tgtakaoka/CyborgHD6309E/schematic/cyborg-hd6309e-prototype5.pdf

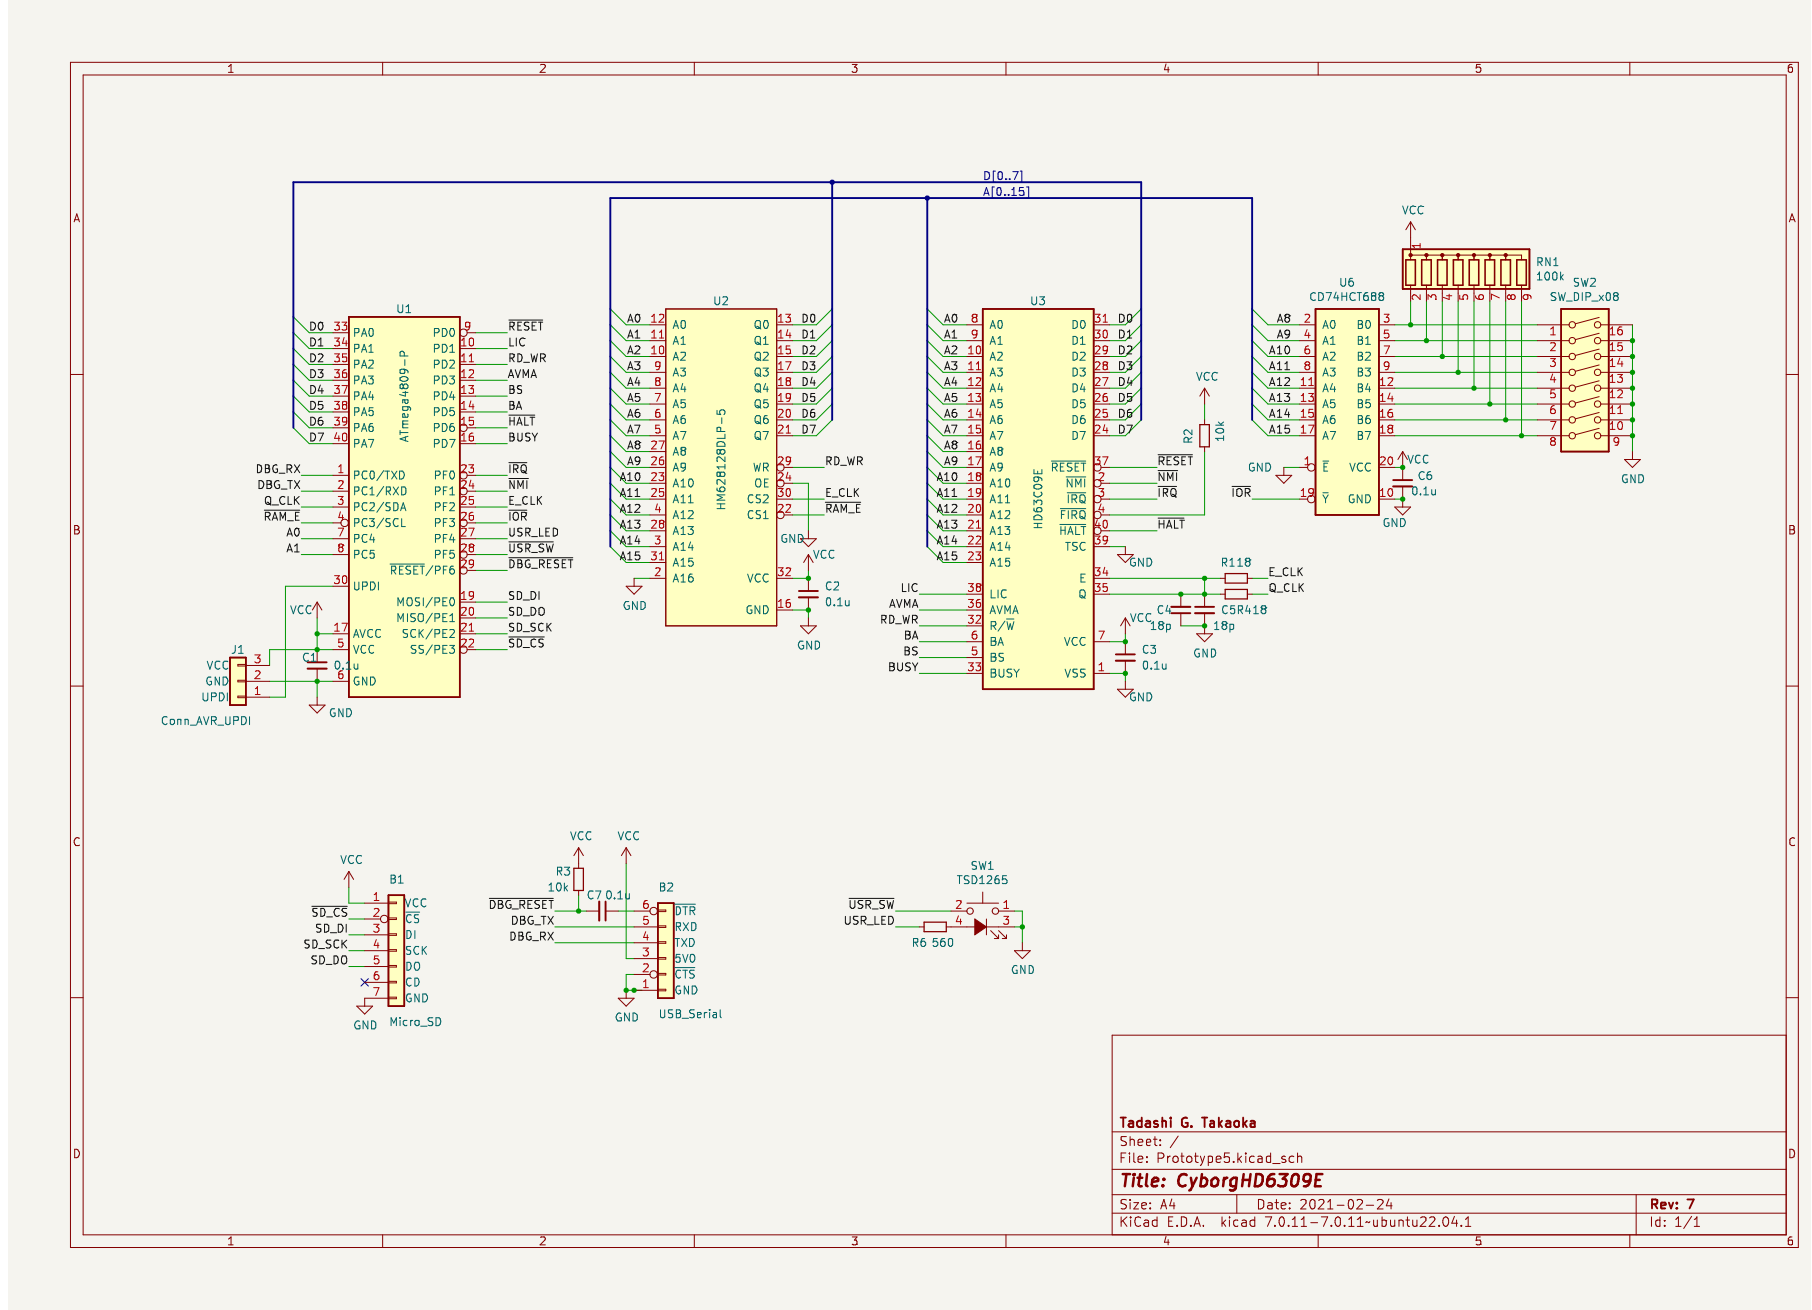
[picture p1: page 1]
