tgtakaoka/CyborgHD6309E/Prototype3/schematic/Prototype3.kicad_pcb

## KiCad design Prototype3/schematic/Prototype3.kicad_pcb (2022-10-26, an earlier design)

Schematic: Prototype3.kicad_sch, Cyborg09 Prototype3

Parts:
C1, C2, C5, C6, C7: 0.1u; C_0603_1608Metric
C3, C4, C8, C9: 22p; C_0402_1005Metric
D1: USR_LED; LED_D3.0mm
J1: Conn_USB_Serial; PinSocket_1x06_P2.54mm_Vertical
J2, J4: Conn_AVR_ISP; PinSocket_1x06_P2.54mm_Vertical
J3: Conn_Micro_SD; PinSocket_1x07_P2.54mm_Vertical
R1, R3, R4: 10k; R_0603_1608Metric
R2: 560; R_0603_1608Metric
SW1: USR_SW; Push_E-Switch_KS01Q01
U1: ATmega1284P-PU; DIP-40_W15.24mm_Socket
U2: HM628128DLP-5; DIP-32_W15.24mm_Socket
U3: HD63C09E; DIP-40_W15.24mm_Socket
U4: ATmega328P-PU; DIP-28_W7.62mm_Socket
Y1, Y2: 20MHz; Crystal_SMD_SeikoEpson_FA238-4Pin_3.2x2.5mm

Connections:
/A0: U1.3 (PB2), U2.12 (A0), U3.8 (A0)
/A1: U1.4 (PB3), U2.11 (A1), U3.9 (A1)
/A2: J4.4 (MISO), U2.10 (A2), U3.10 (A2), U4.18 (PB4)
/A3: J4.5 (MOSI), U2.9 (A3), U3.11 (A3), U4.17 (PB3)
/A4: U2.8 (A4), U3.12 (A4), U4.16 (PB2)
/A5: U2.7 (A5), U3.13 (A5), U4.2 (PD0)
/A6: U2.6 (A6), U3.14 (A6), U4.15 (PB1)
/A7: J4.3 (SCK), U2.5 (A7), U3.15 (A7), U4.19 (PB5)
/A8: U2.27 (A8), U3.16 (A8), U4.14 (PB0)
/A9: U2.26 (A9), U3.17 (A9), U4.3 (PD1)
/A10: U2.23 (A10), U3.18 (A10), U4.4 (PD2)
/A11: U2.25 (A11), U3.19 (A11), U4.5 (PD3)
/A12: U2.4 (A12), U3.20 (A12), U4.6 (PD4)
/A13: U2.28 (A13), U3.21 (A13), U4.11 (PD5)
/A14: U2.3 (A14), U3.22 (A14), U4.12 (PD6)
/A15: U2.31 (A15), U3.23 (A15), U4.13 (PD7)
/AVMA: U1.26 (PC4), U3.36 (AVMA)
/BA: U1.27 (PC5), U3.6 (BA)
/BS: U1.29 (PC7), U3.5 (BS)
/BUSY: U1.25 (PC3), U3.33 (BUSY)
/D0: U1.40 (PA0), U2.13 (Q0), U3.31 (D0)
/D1: U1.39 (PA1), U2.14 (Q1), U3.30 (D1)
/D2: U1.38 (PA2), U2.15 (Q2), U3.29 (D2)
/D3: U1.37 (PA3), U2.17 (Q3), U3.28 (D3)
/D4: U1.36 (PA4), U2.18 (Q4), U3.27 (D4)
/D5: U1.35 (PA5), U2.19 (Q5), U3.26 (D5)
/D6: U1.34 (PA6), U2.20 (Q6), U3.25 (D6)
/D7: U1.33 (PA7), U2.21 (Q7), U3.24 (D7)
/DBG_RX: J1.3 (TXD), U1.14 (RXD0/PD0)
/DBG_TX: J1.2 (RXD), U1.15 (TXD0/PD1)
/E_CLK: U2.30 (CS2), U3.34 (E), U4.27 (PC4)
/LIC: U1.28 (PC6), U3.38 (LIC)
/Q_CLK: U3.35 (Q), U4.28 (PC5)
/RD_WR: U1.24 (PC2), U2.29 (WR), U3.32 (R/~W)
/SD_DI: J2.5 (MOSI), J3.3 (DI), U1.6 (PB5/MOSI)
/SD_DO: J2.4 (MISO), J3.5 (DO), U1.7 (PB6/MISO)
/SD_SCK: J2.3 (SCK), J3.4 (SCK), U1.8 (PB7/SCK)
/USR_LED: D1.2 (A), U1.18 (PD4)
/~ACK: U1.20 (PD6), U4.25 (PC2)
/~DBG_RST: C2.2, J2.1 (~RESET), R1.1, U1.9 (~RESET)
/~HALT: U1.23 (PC1), U3.40 (~HALT)
/~INT: U1.17 (PD3), U4.26 (PC3)
/~IRQ: U1.2 (PB1), U3.3 (~IRQ)
/~NMI: U1.1 (PB0), U3.2 (~NMI)
/~RAM_E: U1.19 (PD5), U2.22 (CS1)
/~RESET: U1.22 (PC0), U3.37 (~RESET)
/~SD_CS: J3.2 (~CS), U1.5 (PB4/~SS)
/~STEP: U1.21 (PD7), U4.24 (PC1)
/~USR_SW: SW1.1, U1.16 (PD2)
GND: C1.2, C3.2, C4.1, C5.2, C6.2, C7.2, C8.2, C9.1, J1.5 (~CTS), J1.6 (GND), J2.6 (GND), J3.7 (GND), J4.6 (GND), R2.1, SW1.2, U1.11 (GND), U1.31 (GND), U2.2 (A16), U2.16 (GND), U2.24 (OE), U3.1 (VSS), U3.39 (TSC), U4.8 (GND), U4.22 (GND)
unnamed: C2.1, J1.1 (~DTR)
unnamed: C3.1, U1.13 (XTAL1), Y1.1
unnamed: C4.2, U1.12 (XTAL2), Y1.2
unnamed: C8.1, U4.9 (XTAL1), Y2.1
unnamed: C9.2, U4.10 (XTAL2), Y2.2
unnamed: D1.1 (K), R2.2
unnamed: J4.1 (~RESET), R4.1, U4.1 (~RESET)
unnamed: R3.1, U3.4 (~FIRQ)
VCC: C1.1, C5.1, C6.1, C7.1, J1.4 (5V0), J2.2 (VCC), J3.1 (VCC), J4.2 (VCC), R1.2, R3.2, R4.2, U1.10 (VCC), U1.30 (AVCC), U2.32 (VCC), U3.7 (VCC), U4.7 (VCC), U4.20 (AVCC)

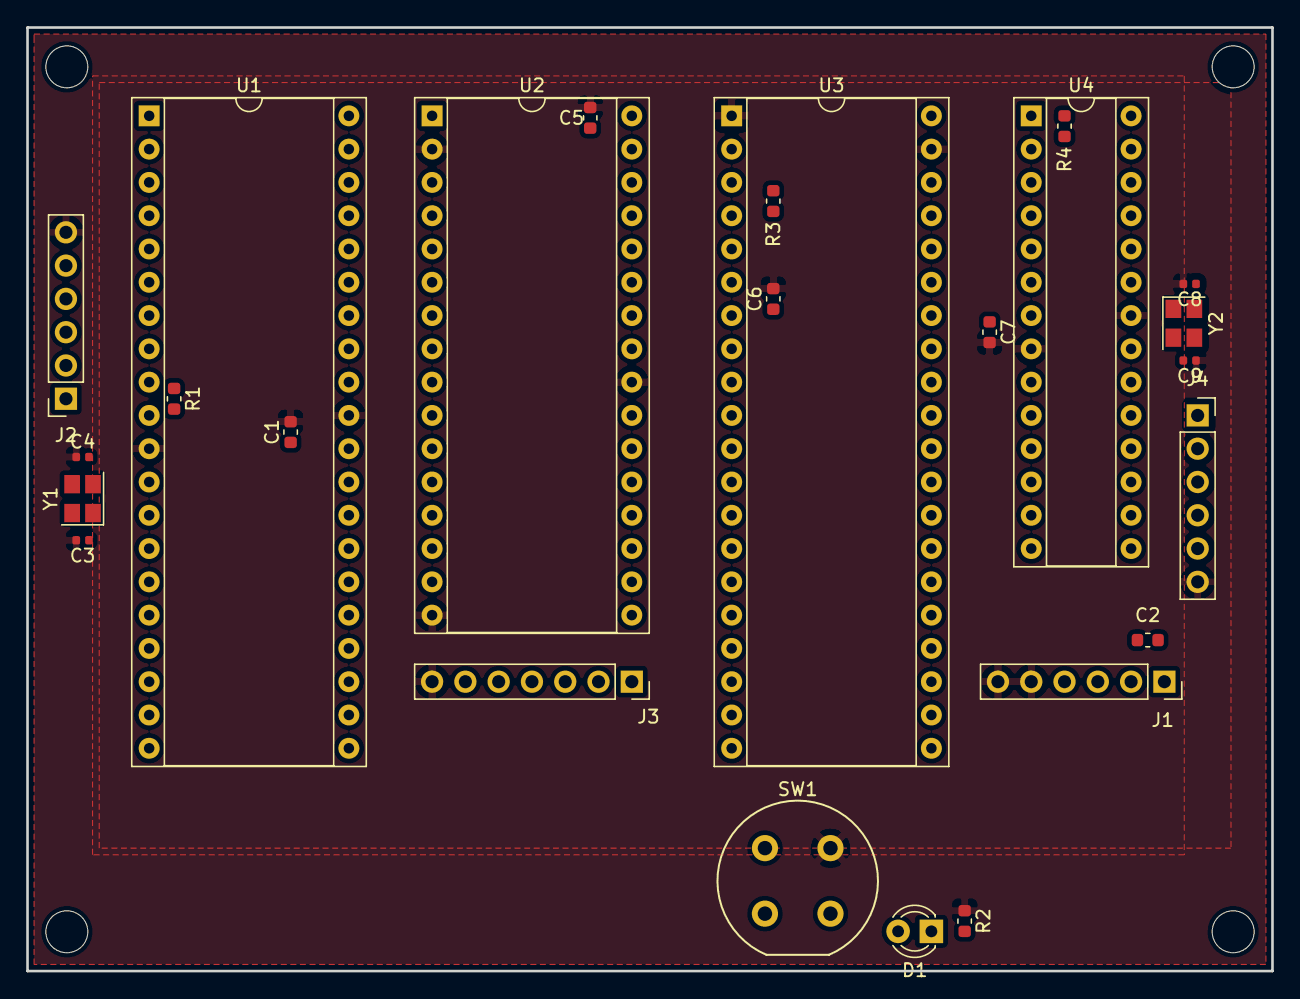
[picture p2: board Prototype3.kicad_pcb from above]

Board: 2 copper layers, 95.0 x 72.0 mm, 29 parts (0 on the bottom side), 59 nets, no tracks yet.

Other parts of the board:
MH1, MH2, MH3, MH4: MountingHole_3.2mm_M3
