tgtakaoka/CyborgHD6309E/schematic/Prototype5.kicad_pcb

## KiCad design schematic/Prototype5.kicad_pcb (2022-10-26)

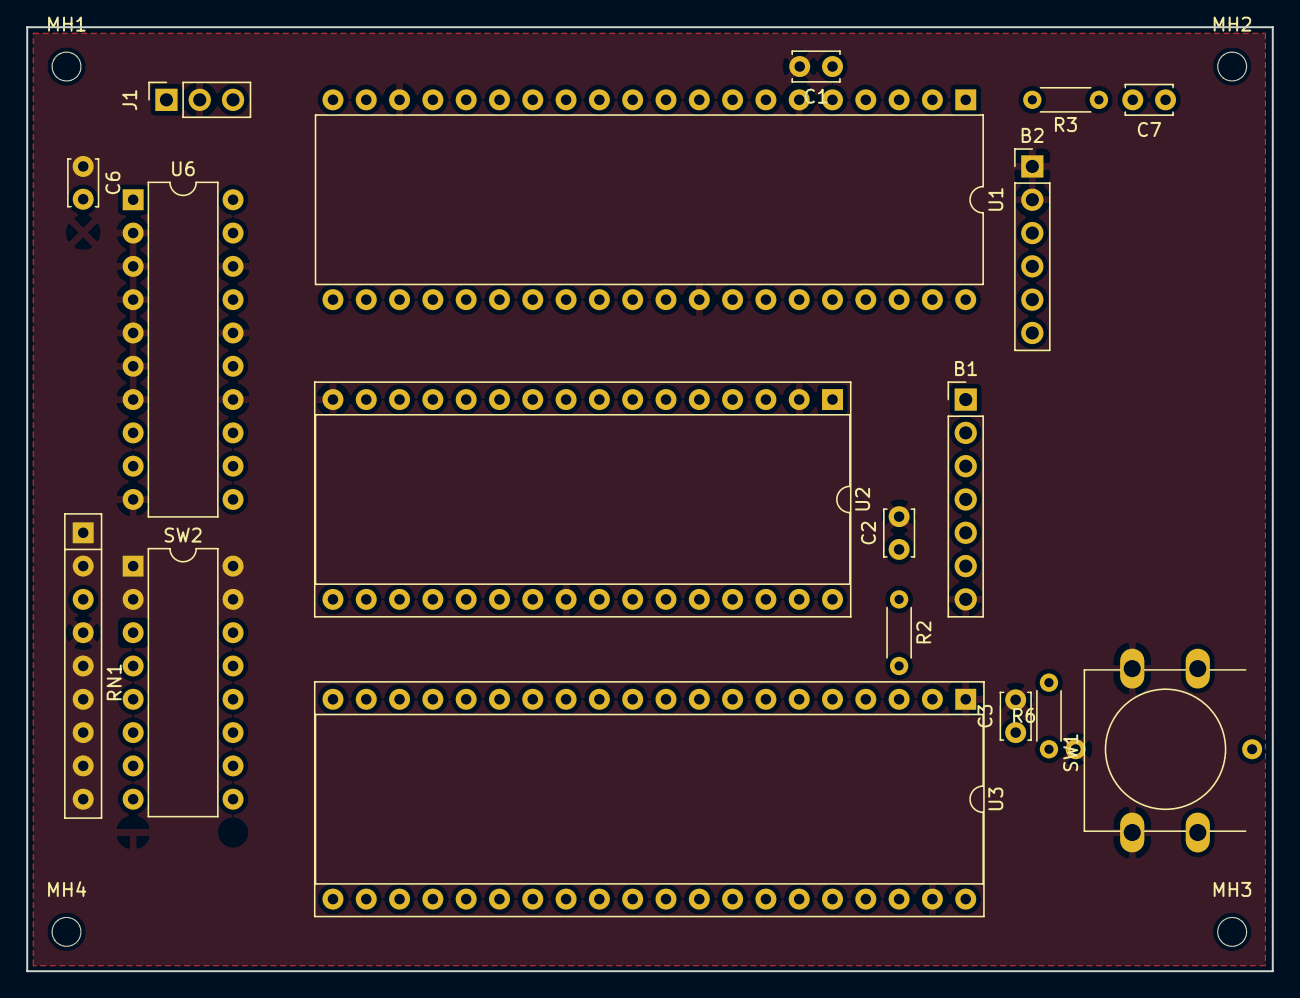
[picture p3: board Prototype5.kicad_pcb from above]

Board: 2 copper layers, 95.0 x 72.0 mm, 22 parts (0 on the bottom side), 61 nets, no tracks yet.

Parts:
B1: Micro_SD; uSD_CARD
B2: USB_Serial; GY232V2
C1, C2, C3, C6, C7: 0.1u; C_Disc_D3.4mm_W2.1mm_P2.50mm
J1: Conn_AVR_UPDI; PinSocket_1x03_P2.54mm_Vertical
MH1, MH2, MH3, MH4: MountingHole_2.2mm_M2
R2, R3: 10k; R_Axial_DIN0204_L3.6mm_D1.6mm_P5.08mm_Horizontal
R6: 560; R_Axial_DIN0204_L3.6mm_D1.6mm_P5.08mm_Horizontal
RN1: 100k; R_Array_SIP9
SW1: TSD1265; SW_PUSH-LED-12mm
SW2: SW_DIP_x08; DIP-16_W7.62mm
U1: ATmega4809-P; DIP-40_W15.24mm
U2: HM628128DLP-5; DIP-32_W15.24mm_Socket
U3: HD63C09E; DIP-40_W15.24mm_Socket
U6: CD74HCT688; DIP-20_W7.62mm

Connections:
/A0: U1.7, U2.12, U3.8
/A1: U1.8, U2.11, U3.9
/A2: U2.10, U3.10
/A3: U2.9, U3.11
/A4: U2.8, U3.12
/A5: U2.7, U3.13
/A6: U2.6, U3.14
/A7: U2.5, U3.15
/A8: U2.27, U3.16, U6.2
/A9: U2.26, U3.17, U6.4
/A10: U2.23, U3.18, U6.6
/A11: U2.25, U3.19, U6.8
/A12: U2.4, U3.20, U6.11
/A13: U2.28, U3.21, U6.13
/A14: U2.3, U3.22, U6.15
/A15: U2.31, U3.23, U6.17
/AVMA: U1.12, U3.36
/BA: U1.14, U3.6
/BS: U1.13, U3.5
/BUSY: U1.16, U3.33
/D0: U1.33, U2.13, U3.31
/D1: U1.34, U2.14, U3.30
/D2: U1.35, U2.15, U3.29
/D3: U1.36, U2.17, U3.28
/D4: U1.37, U2.18, U3.27
/D5: U1.38, U2.19, U3.26
/D6: U1.39, U2.20, U3.25
/D7: U1.40, U2.21, U3.24
/DBG_RX: B2.4, U1.1
/DBG_TX: B2.5, U1.2
/E_CLK: U1.25, U2.30, U3.34
/LIC: U1.10, U3.38
/Q_CLK: U1.3, U3.35
/RD_WR: U1.11, U2.29, U3.32
/SD_DI: B1.3, U1.19
/SD_DO: B1.5, U1.20
/SD_SCK: B1.4, U1.21
/USR_LED: R6.2, U1.27
/~DBG_RESET: C7.2, R3.1, U1.29
/~HALT: U1.15, U3.40
/~IOR: U1.26, U6.19
/~IRQ: U1.23, U3.3
/~NMI: U1.24, U3.2
/~RAM_E: U1.4, U2.22
/~RESET: U1.9, U3.37
/~SD_CS: B1.2, U1.22
/~USR_SW: SW1.2, U1.28
GND: B1.7, B2.1, B2.2, C1.2, C2.2, C3.2, C6.2, J1.2, SW1.1, SW1.3, SW2.9, SW2.10, SW2.11, SW2.12, SW2.13, SW2.14, SW2.15, SW2.16, U1.6, U1.18, U1.32, U2.2, U2.16, U2.24, U3.1, U3.39, U6.1, U6.10
unnamed: B2.6, C7.1
unnamed: J1.1, U1.30
unnamed: R2.2, U3.4
unnamed: R6.1, SW1.4
unnamed: RN1.2, SW2.1, U6.3
unnamed: RN1.3, SW2.2, U6.5
unnamed: RN1.4, SW2.3, U6.7
unnamed: RN1.5, SW2.4, U6.9
unnamed: RN1.6, SW2.5, U6.12
unnamed: RN1.7, SW2.6, U6.14
unnamed: RN1.8, SW2.7, U6.16
unnamed: RN1.9, SW2.8, U6.18
VCC: B1.1, B2.3, C1.1, C2.1, C3.1, C6.1, J1.3, R2.1, R3.2, RN1.1, U1.5, U1.17, U1.31, U2.32, U3.7, U6.20
