tgtakaoka/CyborgHD6309E/(commit log)

2021-10-28 Rename to RetroCyborg
    Since there are a couple of MPUs to be revived as CyborgHD6309 is
    doing, this repository is renamed as RetroCyborg. The MPUs in plan are
    - HD6309E
    - Z84C00
    - R65C02, W65C02S, W65C816S
    - TMS9995
    - MC68008
    [Prototype4.kicad_pcb, Prototype4.sch]
2021-10-28 [HD6309E] Use ATtiny414 + 7430 + 74688 for clock generator
    [Prototype4.kicad_pcb, Prototype4.sch]
2021-10-28 [HD6309E] Update Arduino IDE setting comment
2021-10-28 Restore CyborgHD6309E/Prototype3 code
2021-10-28 [CyborgHD6309E] Update pin_maps.h and schematics
    - Add DBG_RTS for hard flowcontrol of console.
    - Use port A for data bus and port D for controls.
    [Prototype4.kicad_pcb, Prototype4.sch]
2021-10-28 [CyborgHD6309E] Add sample for HD6309
2021-10-28 [CyborgHD6309E] Batch capture and print
2021-10-28 [CyborgHD6309E] Refactor Pins.cycle()
    Now HD6309's native mode works correctly.
    [pins.cpp, pins.h, regs.cpp]
2021-10-28 [CyborgHD6309E] Update pins map
    [Prototype4.kicad_pcb, Prototype4.sch]
2021-10-28 [CyborgHD6309E] Consolidate Prototype3/4 debugger
2021-10-28 [CyborgHD6309E] Restore Prototype3
    [Prototype3.kicad_pcb, Prototype3.sch]
2021-10-28 [CyborgHD6309E] Modify Prototype4 pin maps to upcomming Prototype5
    [Prototype4.kicad_pcb, Prototype4.sch]
2021-10-28 [CyborgHD6309E] Update Prototype3 to libcli 1.0.4
    [Prototype3.sch]
2021-10-28 [CyborgHD6309E] Prototype4/cgen6309e PlatformIO supported
2021-10-28 [CyborgHD6309E] Reorganize Prototype4
    [Prototype4.kicad_pcb, Prototype4.sch]
2021-10-28 [CyborgHD6309E] Add Prototype5 cgen6309e-test
2021-10-28 [CyborgHD6309E] Update Prototype4 pins to compatible with Prototype5
2021-10-28 [CyborgHD6309E] Copy debugger to Prototype5
2021-10-28 [CyborgHD6309E] Add Prototype5
    [Prototype5.kicad_pcb, Prototype5.sch]
2021-10-28 [CyborgHD6309E] Prorotype5 debugger
    [Prototype3.kicad_pcb, Prototype4.kicad_pcb, Prototype5.kicad_pcb, Prototype5.sch]
2021-10-28 [CynorgHD6309E] Add board pin map
2021-10-28 [CyborgHD6309E] Update Prototype3 pins
    [Prototype3.kicad_pcb, Prototype3.sch]
2021-10-28 [CyborgHD6309E] Prototype3 modify pins map
2021-10-28 [CyborgHD6309E] Fix register endian handling
    Values in captured buffer from stack frame is little endian which is
    accidentally equals to AVR's endianess.
    [commands.cpp, regs.cpp, regs.h]
2021-10-28 [CyborgHD6309E] Update Prototype3 debugger to 2.1.0
    Import debugger from Prototype4 and now Prototype can handle HD6309E
    correctly.
    [commands.cpp, debugger.ino, mc6850.cpp, pins.cpp, pins.h, regs.cpp, regs.h]
2021-10-29 [CyborgHD6309E] Update sample
2021-12-12 [CyborgHD6309E] Refactor print out
2022-02-12 [CyborgHD6309E] Make Prototype5 final
    [Prototype5.kicad_pcb, Prototype5.sch]
2022-10-26 Migrate to KiCad 6.0
    [Prototype3.kicad_pcb, Prototype3.kicad_sch, Prototype3.sch, Prototype4.kicad_pcb, Prototype4.kicad_sch, Prototype4.sch, Prototype5.kicad_pcb, Prototype5.kicad_sch]
2023-03-16 Satisfy Electrical Rules Checker
    [Prototype3.kicad_sch, Prototype4.kicad_sch, Prototype5.kicad_sch]
2023-03-16 [CyborgHD6309] Fix old PORTMUX constants
    https://forum.arduino.cc/t/old-iom4809-header-file-is-used/699152
    [pins.cpp]
2024-03-03 Add schematics PDF
2024-05-31 [debugger] Disable Assemble
2024-06-01 [debugger] Simplify disassembler/assembler
2024-06-19 [samples] Add mandelbrot drawing
